ShadowThree/FishFinder/README.md

# FishFinder
Uart convert blueteeth communicate module, PZT ultrasound probe, stm32
