ShadowThree/FishFinder/FishFinder.PDF

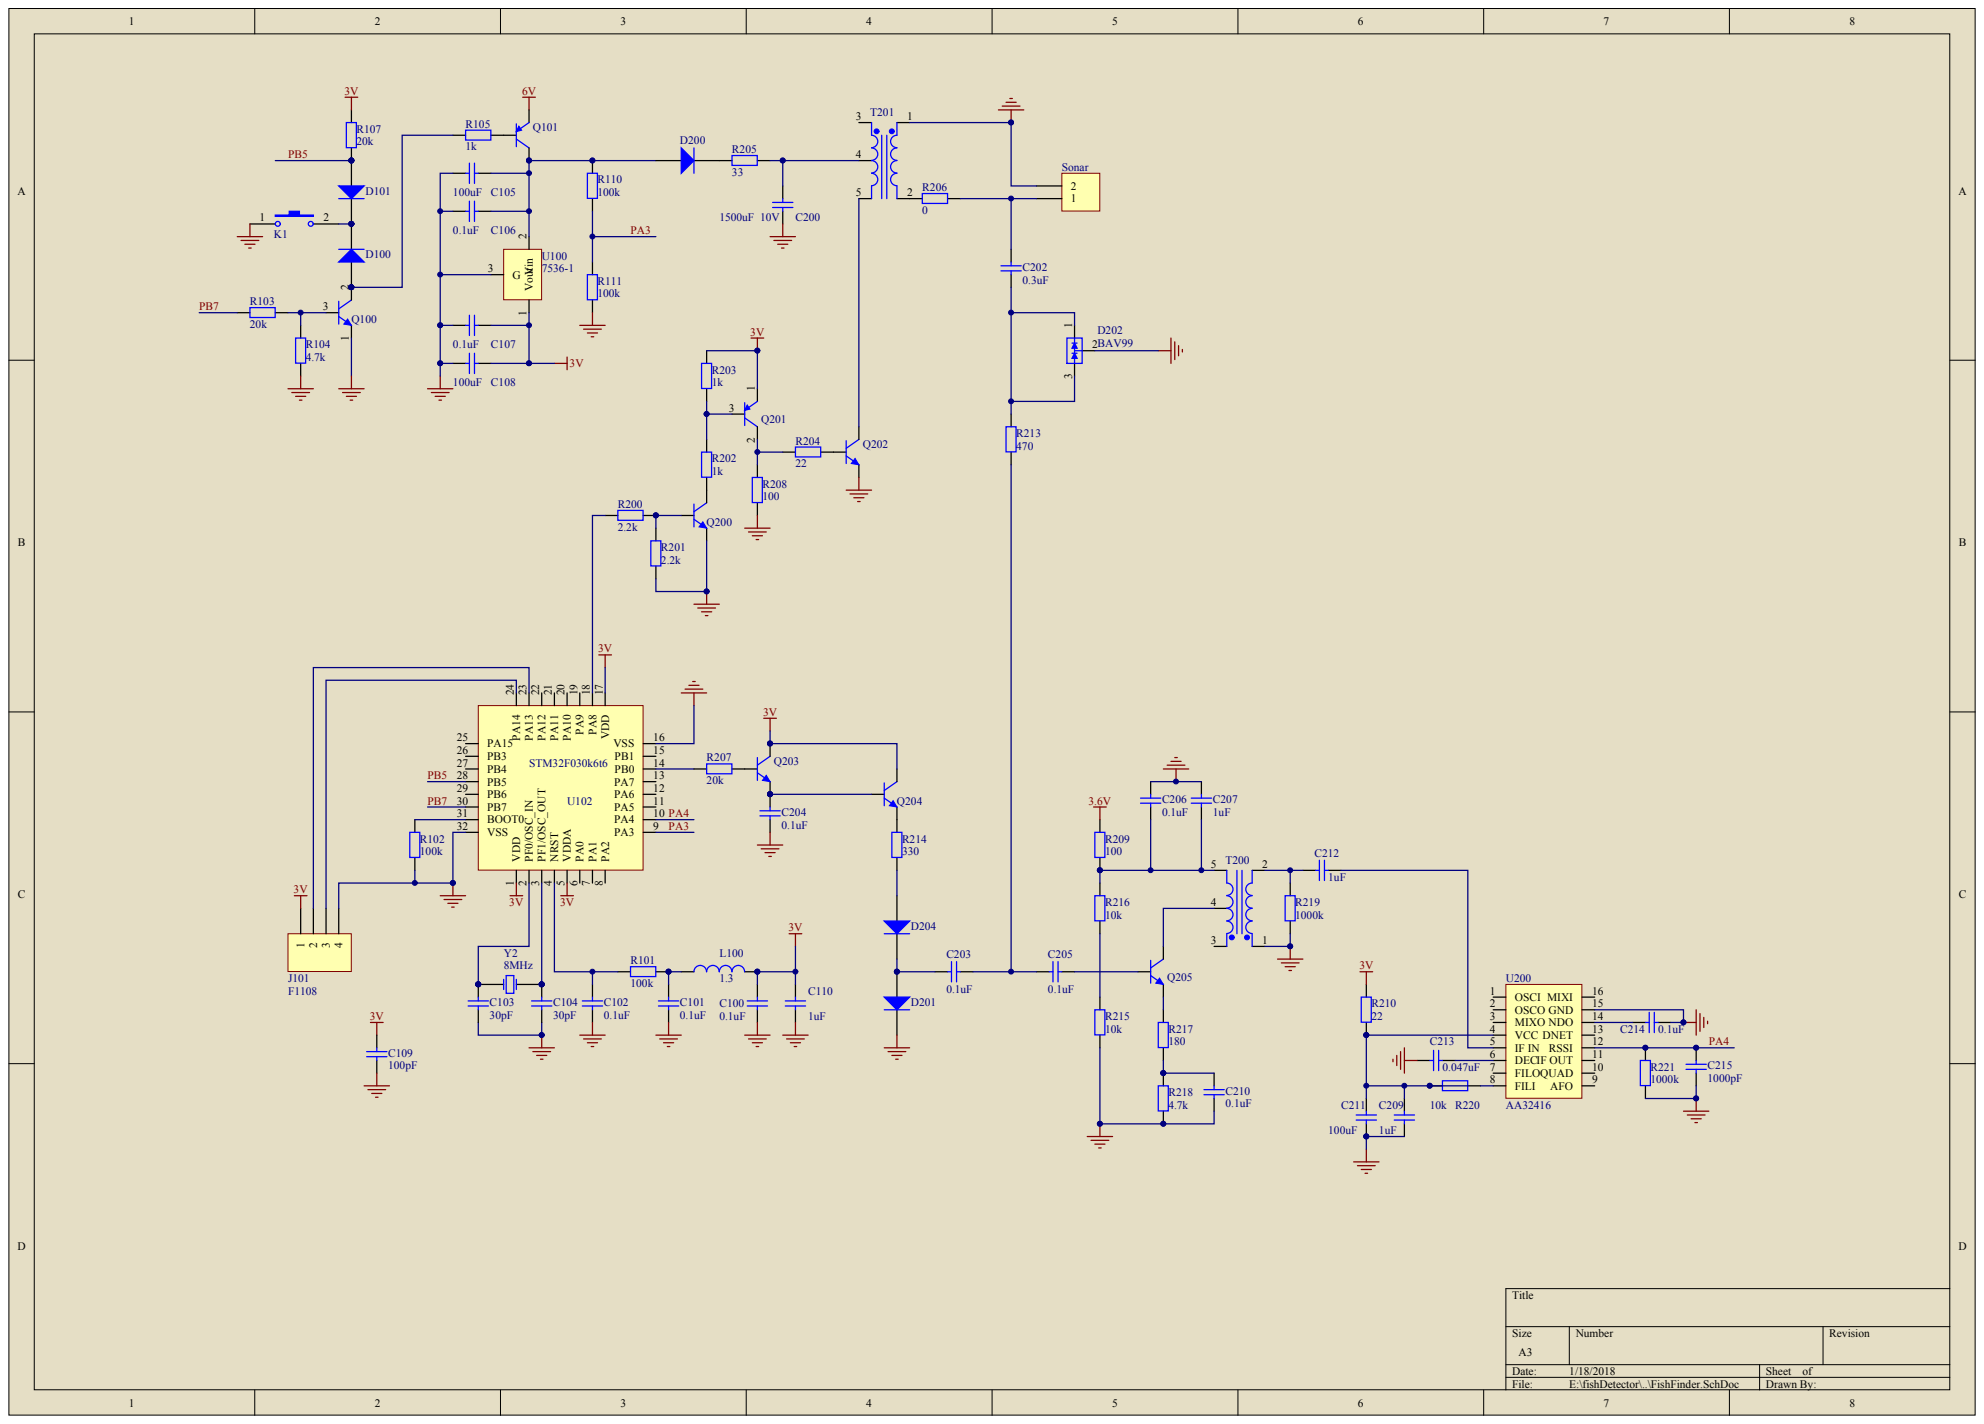
[picture p8: page 1]
