ShadowThree/FishFinder/User/gpio.c

#include "gpio.h"

/**
  * @brief  Initialize all GPIO we need.
  * @param  None
  * @retval None
  */
void InitGPIOs(void)
{
	InitGPIOA6();
	InitGPIOB0();
	InitGPIOA2();   /* LED */
	InitGPIOB4();   /* Bluetooth enable pin */
	InitGPIOB5();    
	InitGPIOB7();
	InitGPIO_Uart();
}

/**
  * @brief  control LED, lighting is mean the board is power-on.
  * @param  None
  * @retval None
  */
void InitGPIOA2(void)
{
	GPIO_InitTypeDef GPIO_InitStruct;
	RCC_AHBPeriphClockCmd(RCC_AHBPeriph_GPIOA, ENABLE);
	GPIO_InitStruct.GPIO_Pin = GPIO_Pin_2;
	GPIO_InitStruct.GPIO_Mode = GPIO_Mode_OUT;
	GPIO_InitStruct.GPIO_OType = GPIO_OType_PP;
  GPIO_InitStruct.GPIO_Speed = GPIO_Speed_Level_3;
  GPIO_Init(GPIOA, &GPIO_InitStruct);
	GPIO_SetBits(GPIOA, GPIO_Pin_2);
}


/**
  * @brief  output 200KHz pulse
  * @param  None
  * @retval None
  * @name
  */
void InitGPIOA6(void)
{
	GPIO_InitTypeDef GPIO_InitStruct;
	RCC_AHBPeriphClockCmd(RCC_AHBPeriph_GPIOA, ENABLE);
	GPIO_InitStruct.GPIO_Pin = GPIO_Pin_6;
	GPIO_InitStruct.GPIO_Mode = GPIO_Mode_AF;
	GPIO_InitStruct.GPIO_OType = GPIO_OType_PP;    ////???????
  GPIO_InitStruct.GPIO_Speed = GPIO_Speed_50MHz;
	GPIO_InitStruct.GPIO_PuPd = GPIO_PuPd_UP;
  GPIO_Init(GPIOA, &GPIO_InitStruct);
	GPIO_PinAFConfig(GPIOA, GPIO_PinSource6, GPIO_AF_1);
}

/**
  * @brief  output a pulse, f = 2.5Hz, DutyCycle = 2.5%
  * @param  None
  * @retval None
  * @name
  */
void InitGPIOB0(void)
{
	GPIO_InitTypeDef GPIO_InitStruct;
	RCC_AHBPeriphClockCmd(RCC_AHBPeriph_GPIOB, ENABLE);
	GPIO_InitStruct.GPIO_Pin = GPIO_Pin_0;
	GPIO_InitStruct.GPIO_Mode = GPIO_Mode_OUT;
	GPIO_InitStruct.GPIO_OType = GPIO_OType_PP;
  GPIO_InitStruct.GPIO_Speed = GPIO_Speed_Level_3;
  GPIO_Init(GPIOB, &GPIO_InitStruct);
}

/**
  * @brief  bluetooth enable pin, high is mean command mode and low is disable the bluetooth
  * @param  None
  * @retval None
  * @name
  */
void InitGPIOB4(void)
{
	GPIO_InitTypeDef GPIO_InitStruct;
	RCC_AHBPeriphClockCmd(RCC_AHBPeriph_GPIOB, ENABLE);
	GPIO_InitStruct.GPIO_Pin = GPIO_Pin_4;
	GPIO_InitStruct.GPIO_Mode = GPIO_Mode_OUT;
	GPIO_InitStruct.GPIO_PuPd = GPIO_PuPd_UP;
	GPIO_InitStruct.GPIO_OType = GPIO_OType_PP;
  GPIO_InitStruct.GPIO_Speed = GPIO_Speed_Level_3;
  GPIO_Init(GPIOB, &GPIO_InitStruct);
	GPIO_ResetBits(GPIOB, GPIO_Pin_4);
}

/**
  * @brief  detector the key
  * @param  None
  * @retval None
  * @name
  */
void InitGPIOB5(void)
{
	GPIO_InitTypeDef GPIO_InitStruct;
	RCC_AHBPeriphClockCmd(RCC_AHBPeriph_GPIOB, ENABLE);
	GPIO_InitStruct.GPIO_Pin = GPIO_Pin_5;
	GPIO_InitStruct.GPIO_Mode = GPIO_Mode_IN;
	GPIO_InitStruct.GPIO_PuPd = GPIO_PuPd_UP;
  GPIO_Init(GPIOB, &GPIO_InitStruct);
}

/**
  * @brief  keep the power
  * @param  None
  * @retval None
  * @name
  */
void InitGPIOB7(void)
{
	GPIO_InitTypeDef GPIO_InitStruct;
	RCC_AHBPeriphClockCmd(RCC_AHBPeriph_GPIOB, ENABLE);
	GPIO_InitStruct.GPIO_Pin = GPIO_Pin_7;
	GPIO_InitStruct.GPIO_Mode = GPIO_Mode_OUT;
	GPIO_InitStruct.GPIO_PuPd = GPIO_PuPd_UP;
  GPIO_Init(GPIOB, &GPIO_InitStruct);
	GPIO_SetBits(GPIOB, GPIO_Pin_7);
}

/**
  * @brief  Configuration the UART's Rx and Tx
  * @param  None
  * @retval None
  * @name
  */
void InitGPIO_Uart(void)
{
	GPIO_InitTypeDef GPIO_InitStructure;
  
  /* USART1 Pins configuration ************************************************/
  /* Connect pin to Periph */
  GPIO_PinAFConfig(GPIOA, GPIO_PinSource9, GPIO_AF_1); 
  GPIO_PinAFConfig(GPIOA, GPIO_PinSource10, GPIO_AF_1);    
  
  /* Configure pins as AF pushpull */
  GPIO_InitStructure.GPIO_Pin = GPIO_Pin_9 | GPIO_Pin_10;
  GPIO_InitStructure.GPIO_Mode = GPIO_Mode_AF;
  GPIO_InitStructure.GPIO_Speed = GPIO_Speed_50MHz;
	GPIO_InitStructure.GPIO_OType = GPIO_OType_PP;
	GPIO_InitStructure.GPIO_PuPd = GPIO_PuPd_UP;
  GPIO_Init(GPIOA, &GPIO_InitStructure);
}
