ShadowThree/FishFinder/User/gpio.h

#ifndef _GPIO_H_
#define _GPIO_H_

#include "stm32f0xx.h"

void InitGPIOs(void);
void InitGPIOA2(void);
void InitGPIOA6(void);
void InitGPIOB0(void);
void InitGPIOB4(void);
void InitGPIOB5(void);
void InitGPIOB7(void);
void InitGPIO_Uart(void);

#endif
