ShadowThree/FishFinder/User/timer.c

#include "timer.h"

void InitTIMs(void)
{
	InitTIM3();
	InitTIM14();
	TIM_Cmd(TIM14, ENABLE);
}
	
/**
  * @brief  create a 200KHz pulse
  * @param  None
  * @retval None
  */
void InitTIM3(void)
{
	TIM_TimeBaseInitTypeDef  TIM_TimeBaseStructure;
	TIM_OCInitTypeDef  TIM_OCInitStructure;
	
	uint16_t TimerPeriod = 0;
	uint16_t Channel1Pulse = 0;
	
	RCC_APB1PeriphClockCmd(RCC_APB1Periph_TIM3, ENABLE);    
	
	TimerPeriod = (SystemCoreClock / 200000) - 1;  // 200KHz
	Channel1Pulse = (uint16_t) (((uint32_t) 5 * (TimerPeriod - 1)) / 10);   // 50% 
	
	TIM_TimeBaseStructure.TIM_Prescaler = 0;
  TIM_TimeBaseStructure.TIM_CounterMode = TIM_CounterMode_Up;  
  TIM_TimeBaseStructure.TIM_Period = TimerPeriod;
  TIM_TimeBaseStructure.TIM_ClockDivision = 0;
  TIM_TimeBaseStructure.TIM_RepetitionCounter = 0;
  TIM_TimeBaseInit(TIM3, &TIM_TimeBaseStructure);
	
	TIM_OCInitStructure.TIM_OCMode = TIM_OCMode_PWM1;                 ///////??????????????????
  TIM_OCInitStructure.TIM_OutputState = TIM_OutputState_Enable;
  TIM_OCInitStructure.TIM_OutputNState = TIM_OutputNState_Enable;
  TIM_OCInitStructure.TIM_OCPolarity = TIM_OCPolarity_High;
  TIM_OCInitStructure.TIM_OCNPolarity = TIM_OCNPolarity_High;
  TIM_OCInitStructure.TIM_OCIdleState = TIM_OCIdleState_Set;
  TIM_OCInitStructure.TIM_OCNIdleState = TIM_OCIdleState_Reset;

  TIM_OCInitStructure.TIM_Pulse = Channel1Pulse;   
  TIM_OC1Init(TIM3, &TIM_OCInitStructure);
	
	TIM_OC1PreloadConfig(TIM3, TIM_OCPreload_Enable);
  TIM_CtrlPWMOutputs(TIM3, ENABLE);	
}

void InitTIM14(void)
{
	NVIC_InitTypeDef NVIC_InitStructure;
	TIM_TimeBaseInitTypeDef TIM_TimeBaseInitStructure;
	
	RCC_APB1PeriphClockCmd(RCC_APB1Periph_TIM14, ENABLE);
	NVIC_InitStructure.NVIC_IRQChannel = TIM14_IRQn;
	NVIC_InitStructure.NVIC_IRQChannelPriority = 0;   // 0~3
	NVIC_InitStructure.NVIC_IRQChannelCmd = ENABLE;
	NVIC_Init(&NVIC_InitStructure);
	
	TIM_TimeBaseInitStructure.TIM_Prescaler = 48 - 1;   /* 48MHz / 48 = 1M */
	TIM_TimeBaseInitStructure.TIM_Period = 10;          /* T = 1/f = 1 / (1M / 10) = 10us */
	TIM_TimeBaseInitStructure.TIM_ClockDivision = 0;
	TIM_TimeBaseInitStructure.TIM_CounterMode = TIM_CounterMode_Up;
	TIM_TimeBaseInit(TIM14, &TIM_TimeBaseInitStructure);
	TIM_ITConfig(TIM14, TIM_IT_Update, ENABLE);
}
